Sim-59/ATtiny-DCC-Function-Decoder/(commit log)

2026-04-13 Update README with Digispark board details and modifications
    Added information about a supplementary board for the Digispark and modifications for use in a model train car.
2026-04-22 Clarify Digispark board and decoder modifications
    Updated details about the Digispark board and decoder modifications for better clarity.
2026-04-22 Revise README for Digispark board and LED integration
    Updated descriptions for the Digispark board and LED light bar integration, including details on transistor usage and ISP programmer connector.
2026-04-22 Clarify modified version details in README
    Updated the description of the modified version for clarity and corrected the number of axles in the PIKO-DR-Rekowagen.
2026-05-30 Revise README for decoder software and hardware updates
    Updated the README to clarify the origin of the decoder software and added details about modifications for LED lighting and dimming capabilities.
2026-06-17 Enhance README with PCB link and PWM details
    Updated README.md to include a link to the complete PCB design and clarified PWM dimming capabilities.
